umartechboy/STM2024/STM_DanBerard/STMDotNet/STM/STM/bin/Debug/scan.tiff

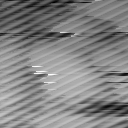
STM_DanBerard/STMDotNet/STM/STM/bin/Debug/scan.tiff
