umartechboy/STM2024/Notes.txt

OPA124, OPA627, LTC6268
40 AWG
100M Resistor
