umartechboy/STM2024/Electronics BoM 20May 2024.xlsx

Sheet: BoM
Item | Description | Quantity | Comments | Source | https://dberard.com/home-built-stm/electronics/
Preamplifier
Power | 9VP
Capacitor | 4.7uF | 1
 | 0.1uF | 1 |  | Bill
Resistor | 100M | 1 |  | Recomended | https://www.digikey.com/short/2w1n4391 |  | $170
 | 220R | 1 |  | Minimal | https://www.digikey.com/short/p2t53f45 |  | $60
Op-Amp | OPA124U/ADA6247 | 1 |  | Mechanical | https://www.mcmaster.com/98625A960/ | https://www.mcmaster.com/catalog/98625A960 | ~$60
Teflon Standoff | 36-11301-ND | 1
 |  |  |  | Overview
ADC
Power | 15VP
Op-Amp | OPA2227 | 2
 | LT1469 | 1
Analog Switch | ADG419 | 2 | Optional
Capacitor | 3.3nF | 4
 | 47nF | 1
 | 100nF | 14
 | 10uF | 5
Resistor | 470R | 4
 | 10K | 1
 | 100R | 1
DAC
Power | 5VP, 15VP
Op-Amp | OPA2227 | 1
 | OPA4227 | 2
Reference | REF102 | 1
DAC | DAC8814 | 1
Analog Switch | ADG419 | 1
Resistor | 30k | 1
 | 10K | 1
 | 3K | 8
 | 1.5K | 4
 | 1K | 1
Capacitor | 3.3nF | 4
 | 4.7nF | 4
 | 2.2uF | 1
 | 10uF | 6
 | 100nF | 11
 | 100uF | 1
Piezo Driver
Power | 15VP
Capacitor | 4.7nF | 6
 | 100nF | 4
Resistor | 3K | 14
 | 220R | 4
Op-Amp | OPA2227 | 2
Controller | Teensy 3.1 | 1 | Or Bluepill
PCB | Scanning Head, Main
Mechanical
Stepper |  | 28byj-48
Insert | 0.438" Long Brass Insert for 1/4"-80 | 98625A960 | https://www.mcmaster.com/catalog/98625A960
Ball-Point screw | 1/4"-80 Thread, 1" Long | 98625A710 | https://www.mcmaster.com/98625A960/

Sheet: DigiKey Export -- Recommended
Index | Quantity | Part Number | Manufacturer Part Number | Description | Customer Reference | Available | Backorder | Unit Price | Extended Price USD
1 | 1 | 505-ADA4627-1ARZ-ND | ADA4627-1ARZ | IC OPAMP JFET 1 CIRCUIT 8SOIC |  | 1 | 0 | 10.34 | 10.34
2 | 1 | 505-ADA4627-1ARZ-ND | ADA4627-1ARZ | IC OPAMP JFET 1 CIRCUIT 8SOIC |  | 1 | 0 | 10.34 | 10.34
3 | 1 | 36-11301-ND | 11301 | TERM TURRET SINGLE L=6.35MM TIN |  | 1 | 0 | 1.29 | 1.29
4 | 1 | 296-18608-1-ND | DAC8814IBDBT | IC DAC 16BIT A-OUT 28SSOP |  | 1 | 0 | 35.88 | 35.88
5 | 2 | OPA4227UA-ND | OPA4227UA | IC OPAMP GP 4 CIRCUIT 14SOIC |  | 2 | 0 | 11.16 | 22.32
6 | 1 | 296-41378-1-ND | PCM1798DBR | IC DAC/AUDIO 24BIT 200K 28SSOP |  | 1 | 0 | 5 | 5
7 | 1 | 296-18608-1-ND | DAC8814IBDBT | IC DAC 16BIT A-OUT 28SSOP |  | 1 | 0 | 35.88 | 35.88
8 | 1 | 296-41378-1-ND | PCM1798DBR | IC DAC/AUDIO 24BIT 200K 28SSOP |  | 1 | 0 | 5 | 5
9 | 1 | 296-41381-1-ND | REF102AU/2K5 | IC VREF SERIES 0.1% 8SOIC |  | 1 | 0 | 4.59 | 4.59
10 | 2 | ADG419BRZ-REEL7CT-ND | ADG419BRZ-REEL7 | IC SWITCH SPDT X 1 35OHM 8SOIC |  | 2 | 0 | 5.62 | 11.24
11 | 2 | 296-26245-1-ND | OPA2227UA/2K5 | IC OPAMP GP 2 CIRCUIT 8SOIC |  | 2 | 0 | 5.36 | 10.72
12 | 1 | 1471-1491-ND | MIKROE-1530 | STEPPER MOTOR PM GEARED UNI 5V |  | 1 | 0 | 8 | 8
13 | 4 | 490-7BB-20-6-ND | 7BB-20-6 | BUZZER ELEMENT STD 6.3KHZ 20MM |  | 4 | 0 | 0.4 | 1.6

Sheet: DigiKey Export -- Minimal
Index | Quantity | Part Number | Manufacturer Part Number | Description | Customer Reference | Available | Backorder | Unit Price | Extended Price USD
1 | 1 | 505-ADA4627-1ARZ-ND | ADA4627-1ARZ | IC OPAMP JFET 1 CIRCUIT 8SOIC |  | 1 | 0 | 10.34 | 10.34
2 | 1 | 296-41378-1-ND | PCM1798DBR | IC DAC/AUDIO 24BIT 200K 28SSOP |  | 1 | 0 | 5 | 5
3 | 1 | 296-18608-1-ND | DAC8814IBDBT | IC DAC 16BIT A-OUT 28SSOP |  | 1 | 0 | 35.88 | 35.88
4 | 4 | 490-7BB-20-6-ND | 7BB-20-6 | BUZZER ELEMENT STD 6.3KHZ 20MM |  | 4 | 0 | 0.4 | 1.6
