umartechboy/STM2024/(list of files, drawings)

Other design files:
STM_DanBerard/STM_Analog/ADC.SchDoc
STM_DanBerard/STM_Analog/Connectors.SchDoc
STM_DanBerard/STM_Analog/DAC.SchDoc
STM_DanBerard/STM_Analog/Piezo Driver.SchDoc
STM_DanBerard/STM_Analog/STM.PcbDoc
STM_DanBerard/STM_Analog/STM_Analog.PrjPcb
