umartechboy/STM2024/STM_DanBerard/STM_Analog/STM_Preamplifier/tunnelAmp.brd

## EAGLE design STM_DanBerard/STM_Analog/STM_Preamplifier/tunnelAmp.brd (2024-05-21)

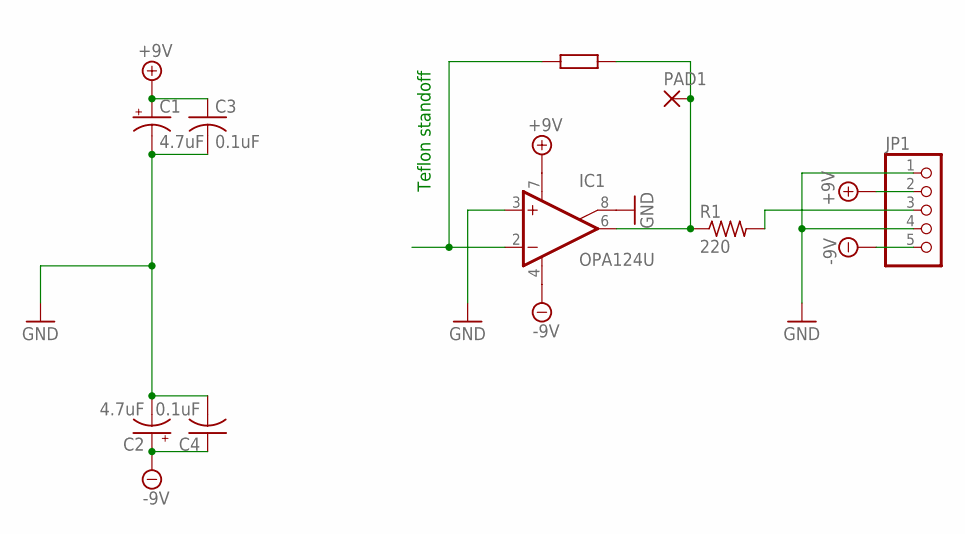
[picture p11: schematic tunnelAmp.sch]

Parts:
C1, C2: 4.7uF; C/6032-28W
C3, C4: 0.1uF; C0603
IC1: OPA124U; SO08
JP1: PINHD-1X5; 1X05
PAD1: 1,6/0,9
R1: 220; R0603

Connections:
+9V: C1.+, C3.1, IC1.7 (V+), JP1.2
-9V: C2.+, C4.1, IC1.4 (V-), JP1.5
GND: C1.-, C2.-, C3.2, C4.2, IC1.3 (+IN), IC1.8 (SUBS), JP1.1, JP1.4
unnamed: IC1.6 (OUT), PAD1.1, R1.1
unnamed: JP1.3, R1.2

Notes on the sheet:
Teflon standoff

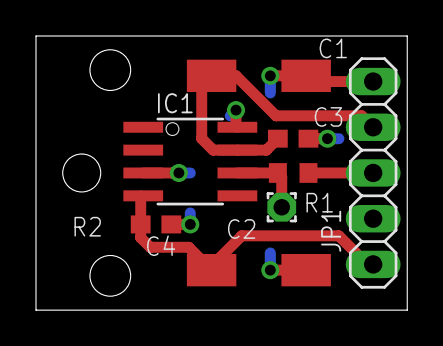
[picture p12: board tunnelAmp.brd from above]

Board: 2 copper layers, 20.6 x 15.2 mm, 8 parts (0 on the bottom side), 5 nets.
